SymonSaroar/sky130-riscv-soc/reports/metrics.csv

run | clock_ns | wns_ns | tns_ns | whs_ns | viol_endpoints | hold_viol | slew_viol | slew_waived | cap_viol | fmax_mhz | wns_mclk_ns | fmax_mclk_mhz | wns_pclk_ns | fmax_pclk_mhz | wns_ss_ns | fmax_ss_mhz | fmax_mclk_ss_mhz | whs_ff_ns | hold_viol_ff | die_um | util_pct | place_density | power_mw | ir_drop_mv | grt_congestion | route_drc | antenna_nets | magic_drc | klayout_drc | klayout_drc_waived | density | lvs | em_viol | lec
01-baseline | 15/10 | -10.063 | -9075.234 | 0.076 | 1210 |  | 3384 | 22 | 156 | 33.3 |  |  |  |  |  |  |  |  |  | 892x892 | 52 | 0.6000 | 8.98 |  | 0 | 0 | 65 | 1943 | 0 |  |  | mismatch
02-sram-corner | 20 |  |  |  |  |  |  |  |  |  |  |  |  |  |  |  |  |  |  |  | 52 |  |  |  | 4290
03-sram-channels | 15/10 | -8.855 | -8749.597 | 0.084 | 1218 |  | 3941 | 22 | 190 | 34.7 |  |  |  |  |  |  |  |  |  | 892x892 | 52 | 0.6000 | 9.10 |  | 0 | 0 | 48 | 0 | 0 |  |  | mismatch
04-cts-setup-repair | 20 |  |  |  |  |  |  |  |  |  |  |  |  |  |  |  |  |  |  |  | 53 |  |  |  | 0
05-placement-padding | 15/10 | -3.677 | -3405.824 | 0.077 | 1209 |  | 1834 | 22 | 145 | 42.2 |  |  |  |  |  |  |  |  |  | 892x892 | 53 | 0.6000 | 9.53 |  | 0 | 0 | 102 | 0 | 0 |  |  | clean
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
