SymonSaroar/sky130-riscv-soc/reports/48-hold-margin/pads.csv

pad | net | type | side | x_um | y_um | opening_w_um | opening_h_um | cell
1 | sdram_ba[1] | output | south | 257.500 | 84.215 | 60.000 | 70.000 | sky130_ef_io__gpiov2_pad_wrapped
2 | sdram_ba[0] | output | south | 342.500 | 84.215 | 60.000 | 70.000 | sky130_ef_io__gpiov2_pad_wrapped
3 | VSSA | analog ground | south | 417.500 | 84.600 | 60.000 | 70.000 | sky130_ef_io__vssa_hvc_clamped_pad
4 | VDDA | 3.3 V analog | south | 492.500 | 84.600 | 60.000 | 70.000 | sky130_ef_io__vdda_hvc_clamped_pad
5 | sdram_a[12] | output | south | 567.500 | 84.215 | 60.000 | 70.000 | sky130_ef_io__gpiov2_pad_wrapped
6 | sdram_a[11] | output | south | 652.500 | 84.215 | 60.000 | 70.000 | sky130_ef_io__gpiov2_pad_wrapped
7 | sdram_a[10] | output | south | 727.500 | 84.215 | 60.000 | 70.000 | sky130_ef_io__gpiov2_pad_wrapped
8 | sdram_a[9] | output | south | 812.500 | 84.215 | 60.000 | 70.000 | sky130_ef_io__gpiov2_pad_wrapped
9 | VCCD | 1.8 V core | south | 907.500 | 84.600 | 60.000 | 70.000 | sky130_ef_io__vccd_lvc_clamped_pad
10 | VSSD | core ground | south | 982.500 | 84.600 | 60.000 | 70.000 | sky130_ef_io__vssd_lvc_clamped_pad
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
