SymonSaroar/sky130-riscv-soc/reports/30-clk-100mhz/layout.png

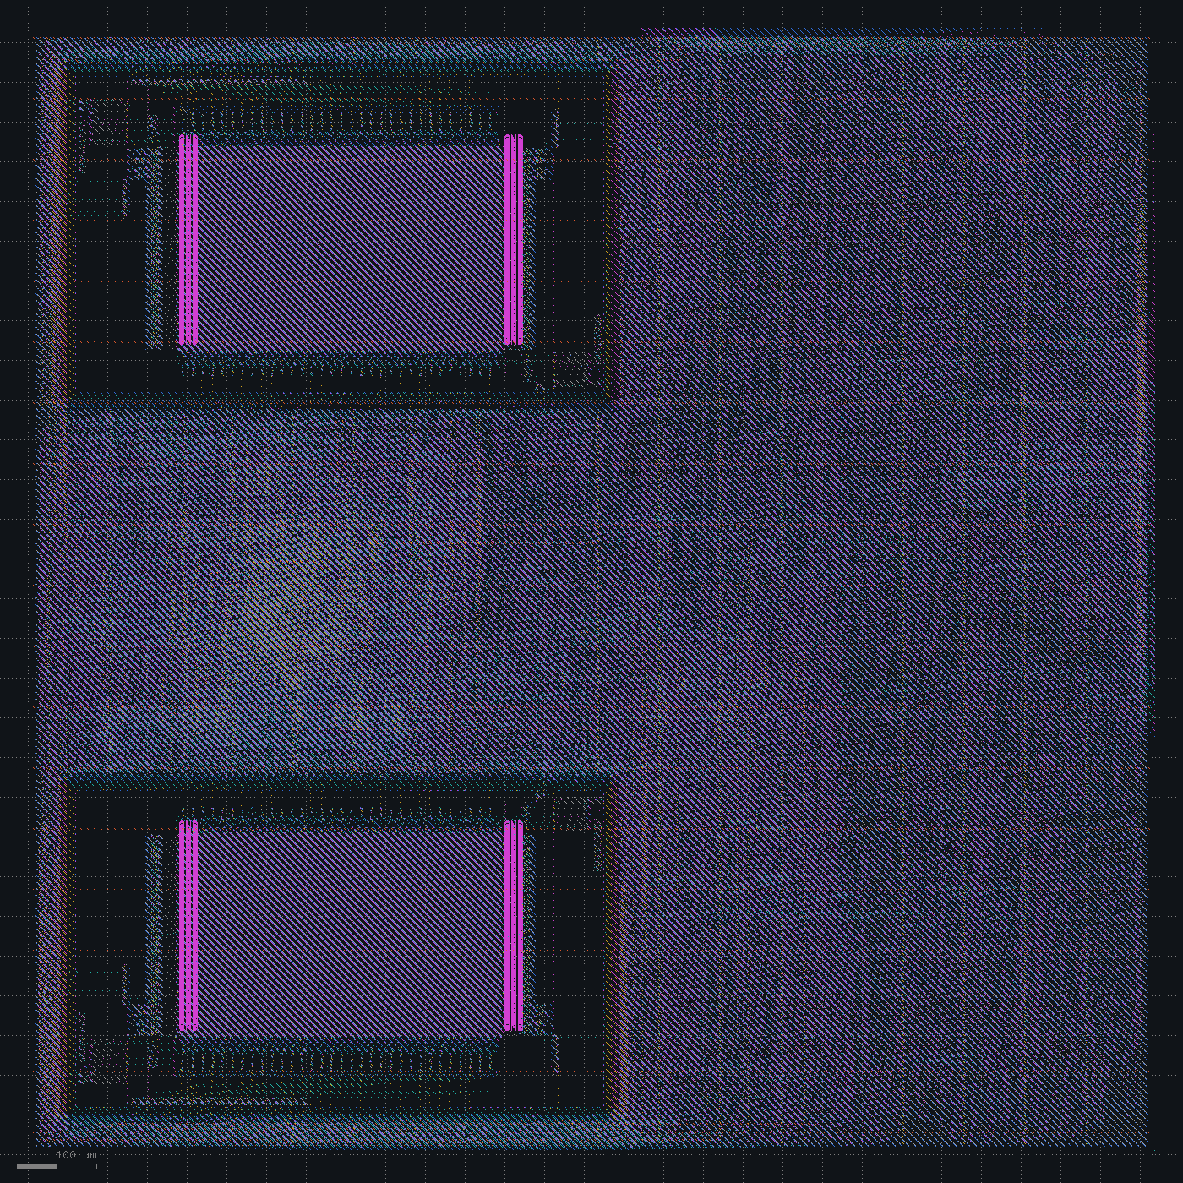
reports/30-clk-100mhz/layout.png
