SymonSaroar/sky130-riscv-soc/docs/journal/timing-optimization.md

# Timing optimization

Spec: [spec_v5.md](../spec_v5.md). The system clock target moves from 66.7 to 100 MHz (10 ns). The UART divisor becomes 868, and the delay limit on crossings between `clk` and `pclk` becomes 10 ns. RTL simulation passes. The benchmark takes 11,555 cycles cold and 10,859 warm; cold grows because a cache refill from SDRAM now costs more `clk` cycles.

| Change | Setup WNS clk / mclk / pclk (ns) | Failing endpoints | Hold WNS (ns) | DRC / LVS |
|---|---|---|---|---|
| `clk` at 10 ns | -4.11 / +2.28 / +5.30 | 1904 | +0.075 | clean |
| Register-read stage, bus request from WB registers, three-cycle multiply | -0.39 / +2.18 / +5.47 | 10 | +0.079 | clean |
| Kogge-Stone carry | -0.40 / +2.21 / +5.43 | 5 | +0.077 | clean |
| Booth-encoded multipliers | -1.02 / +2.19 / +5.41 | 34 | +0.077 | clean |
| Setup repair after CTS without buffer insertion | -1.85 / +2.19 / +5.44 | 37 | +0.077 | clean |
| Buffer insertion after CTS, multiplier operand registers, resets on constant-loaded registers | -0.54 / +1.93 / +5.39 | 11 | +0.075 | clean |
| Fetch ahead of the cache hit | +0.01 / +2.02 / +5.38 | 0 | +0.029 | clean |
| Resets on the remaining control registers | +0.24 / +1.99 / +5.36 | 0 | +0.066 | clean |

## 10 ns

Synthesis gives the same netlist as before, gate for gate: the ABC delay target follows the clock, and 10 ns maps the same as 15 ns.

`clk` misses by 4.11 ns (70.9 MHz) on 1904 endpoints. `mclk`, `pclk` and hold close, DRC and LVS are clean, and power is 63.3 mW. Every failing path starts at the EX instruction register: decode, register file read, then the ALU or an adder. They end in the register file (992), in the PCIe and SDRAM command FIFOs through the interconnect (508), at the fetch address, in the CSRs and in the multiplier's partial products.

The worst paths also carry delay chains. Timing repair after CTS builds chains of `buf_1` cells with one load each, up to 39 in a row. The longest before the PCIe port was 4; with it there were already 45, hidden by the 15 ns clock.

A candidate with a register-read stage and the bus request driven from registers ran through CTS at -3.68 ns, against -7.17 ns without it. Its worst path ran from the multiplier's partial products through their 66-bit sum, the new forwarding mux and into an operand register.

Decision: a register-read stage between ID and EX with forwarding from EX, the bus request driven from WB registers, and the multiply sum registered before writeback.

## Register-read stage

RR sits between ID and EX. It reads the register file and registers both operands, taking the EX result instead when EX writes the register being read. An instruction that reads a register still being loaded waits in RR until the cycle after the response. WB drives the bus from registers, so EX only waits for WB to be free. A multiply takes a cycle for the partial products, one for their sum and one to write back. A taken branch or jump now costs two cycles.

The benchmark takes 13,192 cycles cold and 12,484 warm, 15% more than without the stage. Five mutations each hang the firmware: no forwarding to either operand, no wait for a load in EX or in WB, and no flush of RR on a taken branch. Gate-level simulation passes.

Synthesis gives 28,610 cells (889k µm²) and 5,587 flops.

`clk` misses by 0.39 ns (96.2 MHz) on 10 endpoints, TNS -2.1 ns. `mclk`, `pclk` and hold close. DRC and LVS are clean. The die is 1426 x 1426 µm and power 66.7 mW.

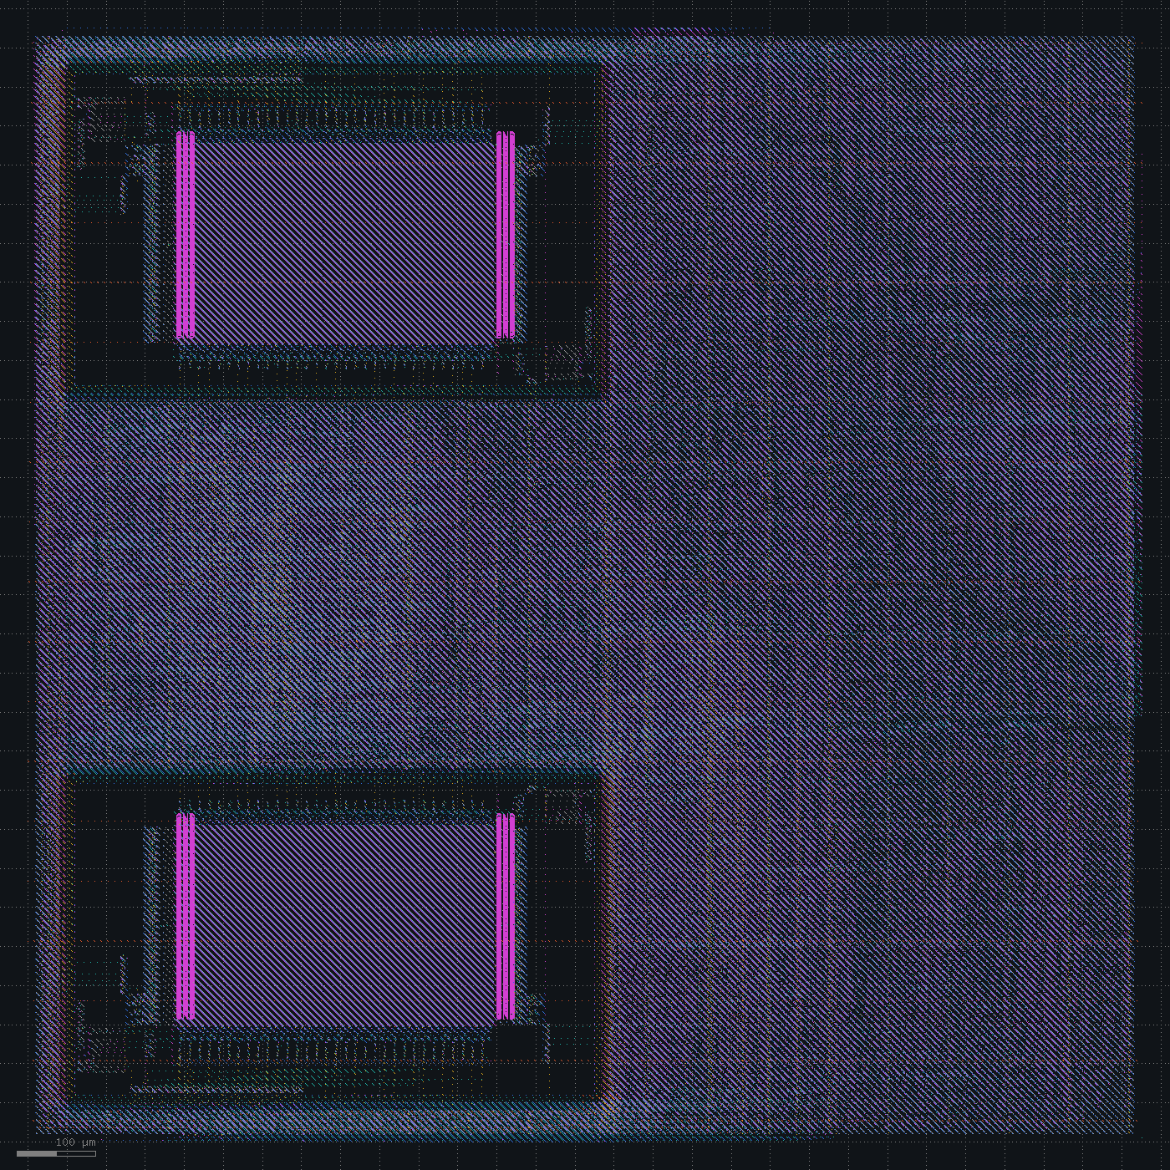
[picture p11: reports/31-register-read-stage/layout.png]
layout


The failing endpoints:

| Path | Worst slack (ns) | Endpoints |
|---|---|---|
| EX instruction register to the fetch address, through the branch target adder | -0.39 | 5 |
| Partial products to the multiply sum | -0.38 | 2 |
| Operand to the partial products | -0.21 | 3 |

The worst path is 46 cells. After decode and the immediate select, the target adder `pc + imm` is a chain of about 30 cells, 7.6 ns. Yosys builds the carry as a Brent-Kung tree, and ABC maps it into that chain. Delay chains are shorter here: the longest is 21, and the failing paths carry at most 10.

Decision: Kogge-Stone carry for adders and comparators in synthesis.

## Kogge-Stone carry

Synthesis maps the carry of every adder and comparator as a Kogge-Stone tree. The design grows by 2k µm² to 891k µm² and 28,797 cells. Gate-level simulation passes.

The fetch address and the multiply sum now close. `clk` still misses by 0.40 ns (96.2 MHz), on 5 endpoints, TNS -0.82 ns, all of them partial-product registers. From the operand register, the 17x17 multiply takes about 10 ns, 48 cells including 6 rebuffers. `mclk`, `pclk` and hold close. DRC and LVS are clean. Power rises from 66.7 to 88.3 mW; the vectorless estimate puts the increase in combinational logic, 4.1 to 25.9 mW. `u_sram.mem/dout1[10]` is over its load limit again, 0.07 against 0.03 pF.

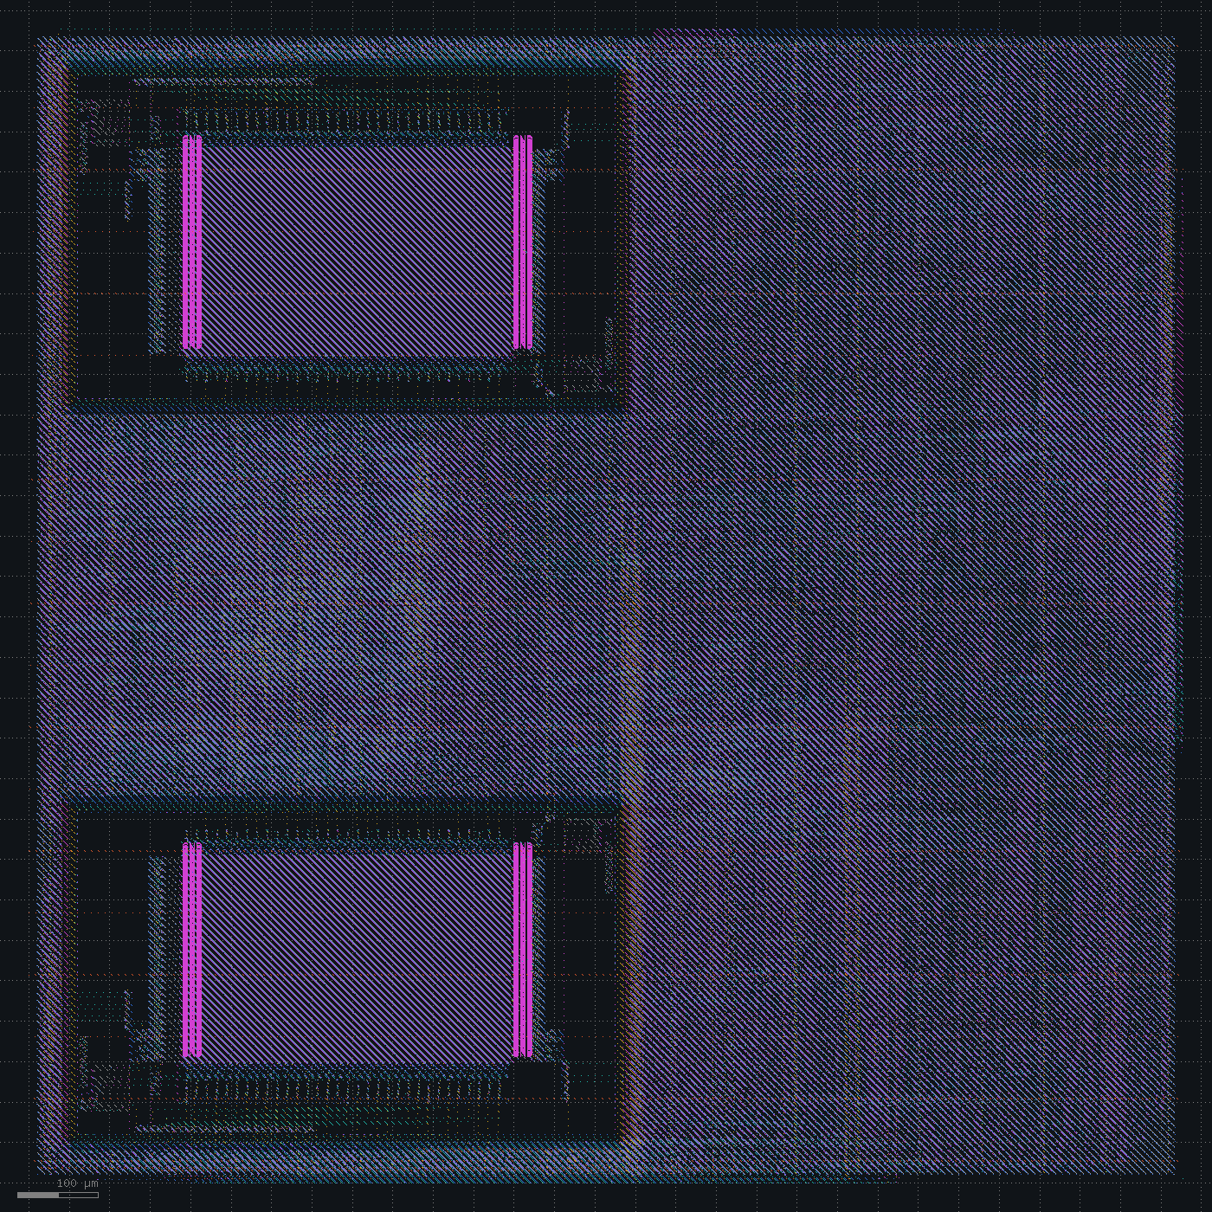
[picture p12: reports/32-kogge-stone/layout.png]
layout


A candidate with Booth-encoded multipliers ran through CTS. No partial-product register was among its 400 worst endpoints; 21 were with Kogge-Stone carry alone.

Decision: Booth-encoded multipliers.

## Booth multipliers

Synthesis builds the multipliers with Booth encoding: 27,766 cells and 882k µm², 9k µm² less than before.

`clk` gets worse: -1.02 ns (90.7 MHz) on 34 endpoints. `mclk`, `pclk` and hold close, DRC and LVS are clean, and one antenna net is left. Power drops to 66.8 mW.

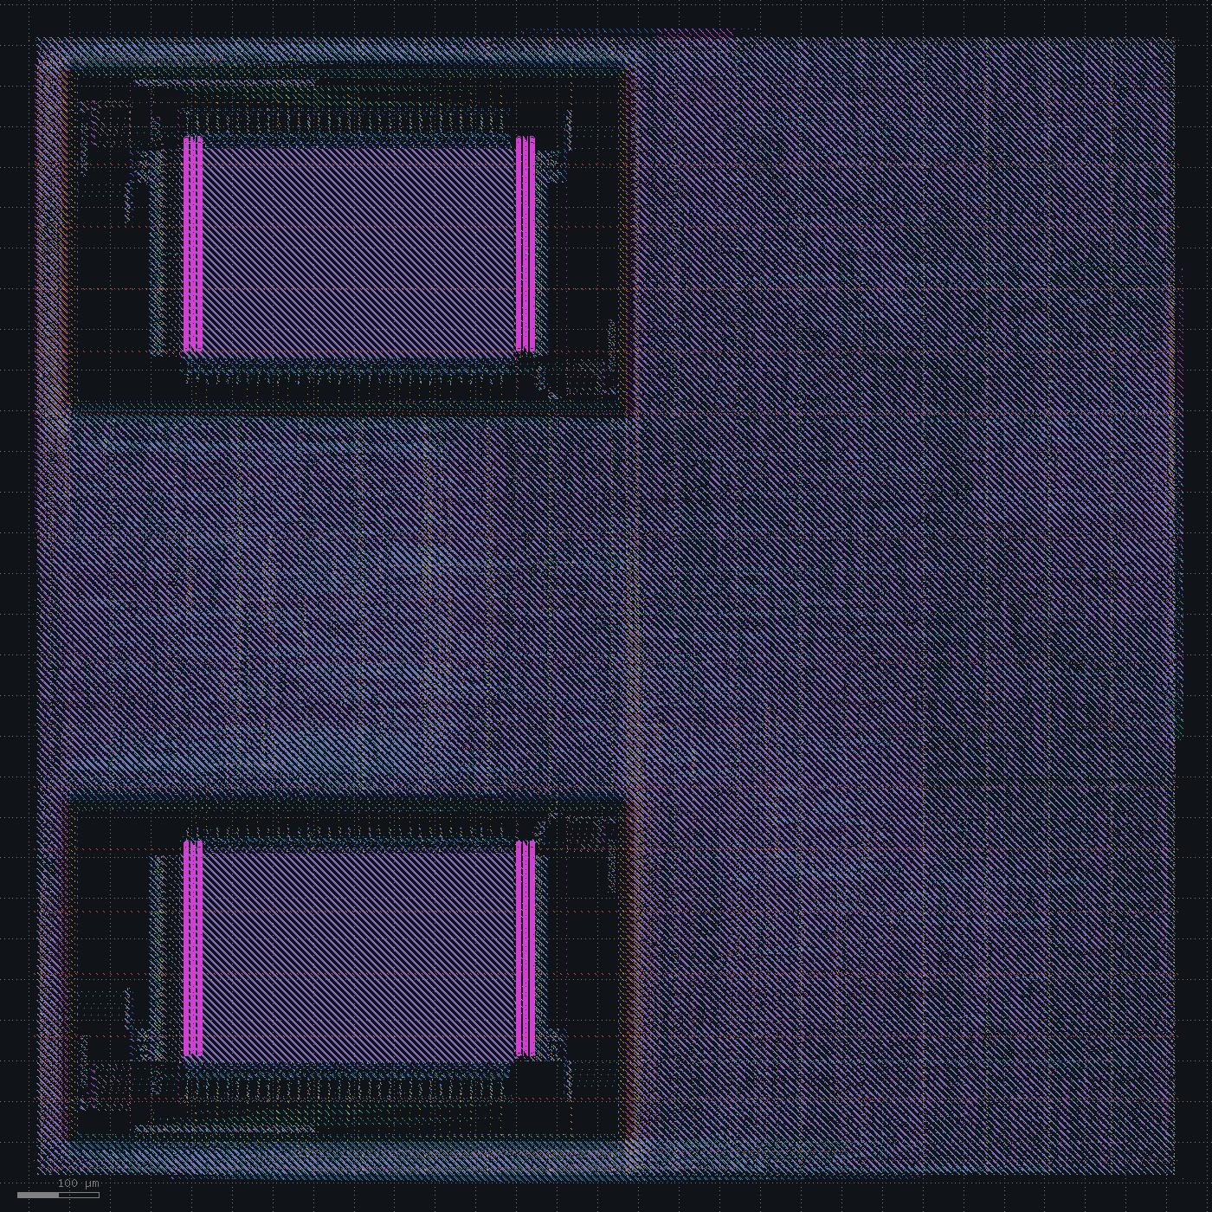
[picture p13: reports/33-booth/layout.png]
layout


| Path | Worst slack (ns) | Rebuffers on the worst path |
|---|---|---|
| Operand to a partial-product register | -1.02 | 47, 5.9 ns |
| Instruction cache hit to the fetch address | -0.94 | 4, 0.65 ns |
| SRAM load data to the register file | -0.11 | 0 |

The multiplier logic on the worst path takes 5.7 ns, then 37 rebuffers in a row, all within 15 µm of each other, add 4.3 ns. The Kogge-Stone layout's failing paths carried 1.1 to 1.2 ns of rebuffers as well. Setup repair after CTS works from the placement estimate, which starts at -11.74 ns here; signoff ends at -1.02 ns. The repair after global routing has skipped buffer insertion for the same kind of gap since it went resize-only.

Gate-level simulation hangs at the first PCIe read. The receive CRC `rp_crc` has no reset and is loaded with all ones when the check of a TLP starts. In this netlist the load leaves it X, and the X reaches the transaction FSM through the LCRC compare. The Kogge-Stone netlist, from the same RTL, passes.

Decision: setup repair after CTS without buffer insertion.

## No buffer insertion after CTS

Setup repair after CTS only resizes, swaps pins and clones: 1197 cells resized, 183 cloned, no buffers. The netlist is the same as with Booth multipliers.

`clk` gets worse again: -1.85 ns (84.4 MHz) on 37 endpoints. `mclk`, `pclk` and hold close, DRC and LVS are clean, and power is 66.8 mW. No failing path carries a rebuffer, but the same paths are slower without them:

| Path | With buffering, worst slack (ns) | Without, worst slack (ns) |
|---|---|---|
| Operand to a partial-product register | -1.02 | -1.85 |
| Instruction cache hit to the fetch address | -0.94 | -1.55 |

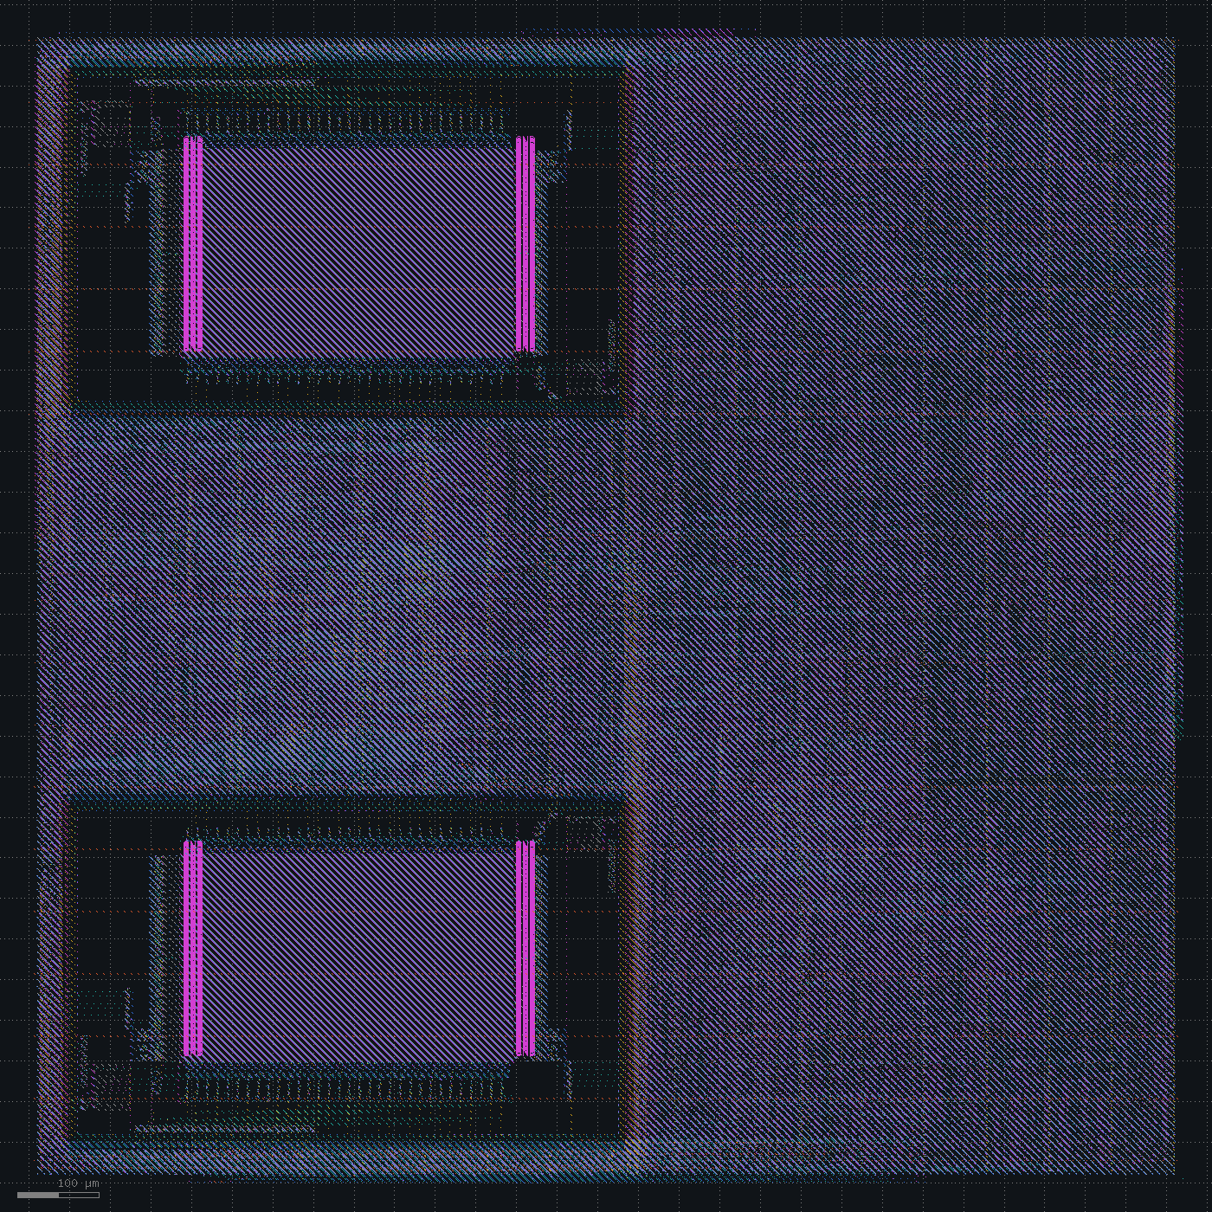
[picture p14: reports/34-cts-no-buffering/layout.png]
layout


Buffer insertion after CTS does real work, chains included.

The multiplier operands are `x1` and `x2`, which also feed the ALU, the shifter, the comparators, the address adder and the divider. On the Kogge-Stone layout's worst path the operand bit passed four buffers, 1.2 ns, before the first multiplier gate. The receive CRC is not the only register that is loaded with a constant before first use and has no reset: so are the transmit CRC, the K flags of the retry buffer, the divider's remainder and count, and the cache refill counter.

Decision: buffer insertion after CTS again, multiplier operands in their own registers, loaded in RR for a multiply only, and a reset on every register that is loaded with a constant before first use.

## Multiplier operand registers

RR loads two 33-bit multiplier operand registers, sign-extended, only when the instruction is a multiply. The partial products start from them. Six more registers get a reset. Synthesis gives 28,023 cells and 5,658 flops. Two mutations fail check 38: operands without forwarding, and without sign extension. Gate-level simulation passes, the PCIe test included.

The multiplier closes: its worst path has +0.42 ns. `clk` misses by 0.54 ns (94.8 MHz) on 11 endpoints, all of them on one path: the cache tag lookup and hit compare, then the select of the next fetch address, into `f_pc`, the cache's address register and the fetch source flag. The path is 53 cells with 0.7 ns of rebuffers. `mclk`, `pclk` and hold close. DRC and LVS are clean. Power is 67.9 mW.

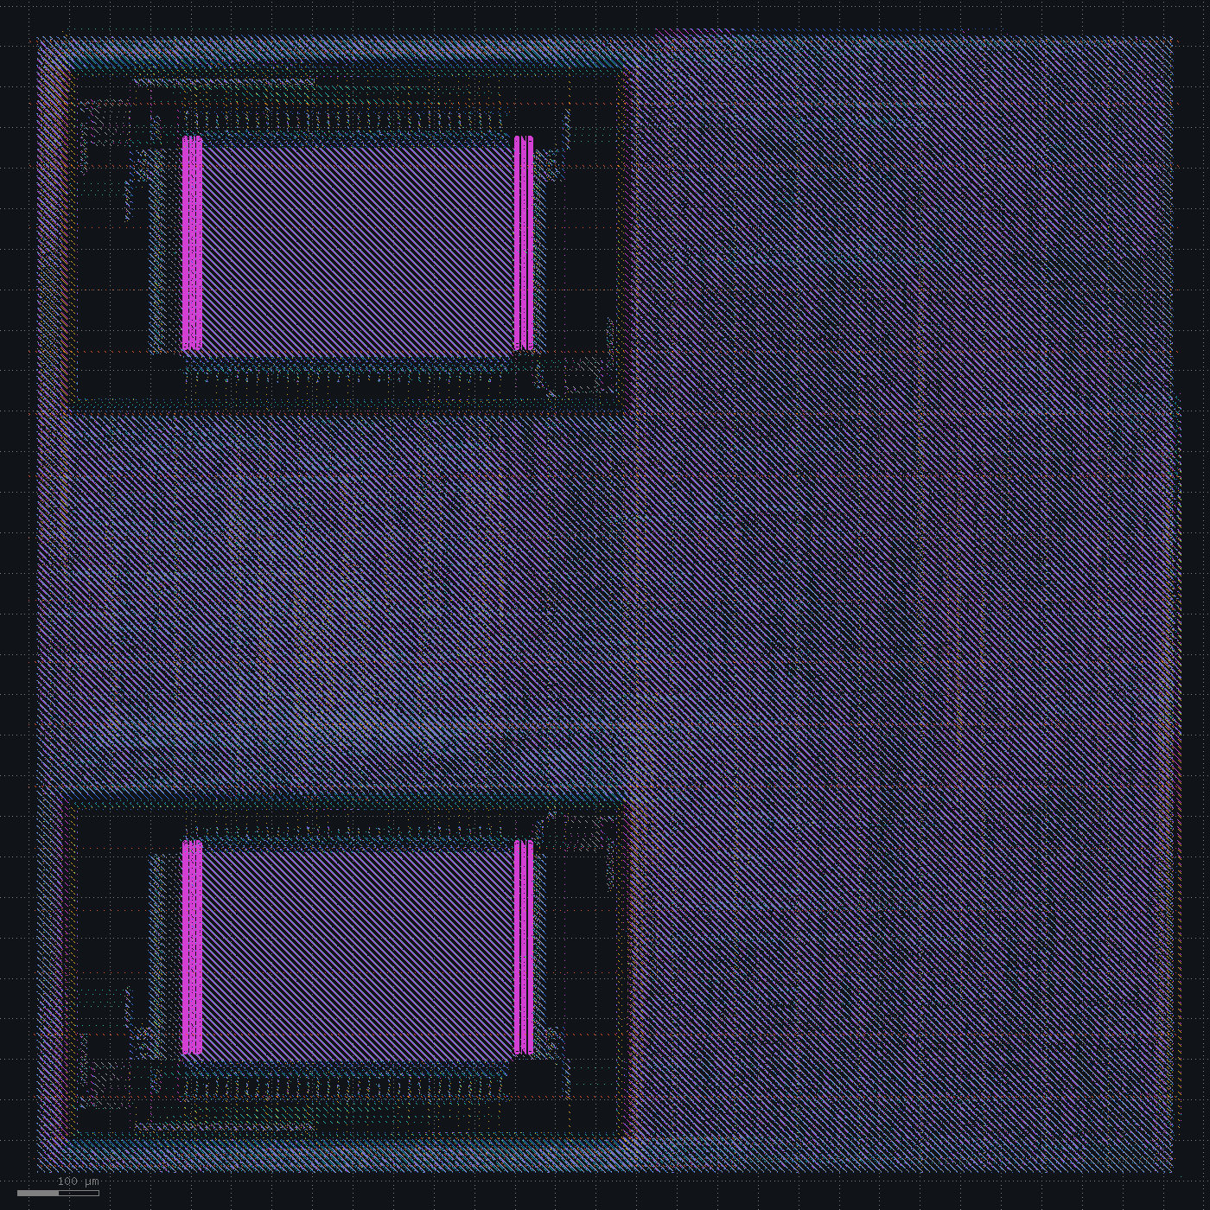
[picture p15: reports/35-mul-operand-regs/layout.png]
layout


Decision: fetch runs ahead without waiting for the cache hit; after a miss, the next fetch goes back to the address that missed.

## Fetch ahead of the cache hit

The next fetch address no longer depends on the cache hit. After a miss, a registered flag sends the next fetch back to the address that missed and drops the word already in flight, so a miss costs at most one more cycle. The benchmark cycle counts do not change. Two mutations fail: keeping the word in flight fails check 42, and not going back hangs the firmware.

Timing closes at 10 ns: `clk` +0.01 ns (100.1 MHz), `mclk` +2.02 ns, `pclk` +5.38 ns, hold +0.029 ns. DRC and LVS are clean. Power is 67.3 mW.

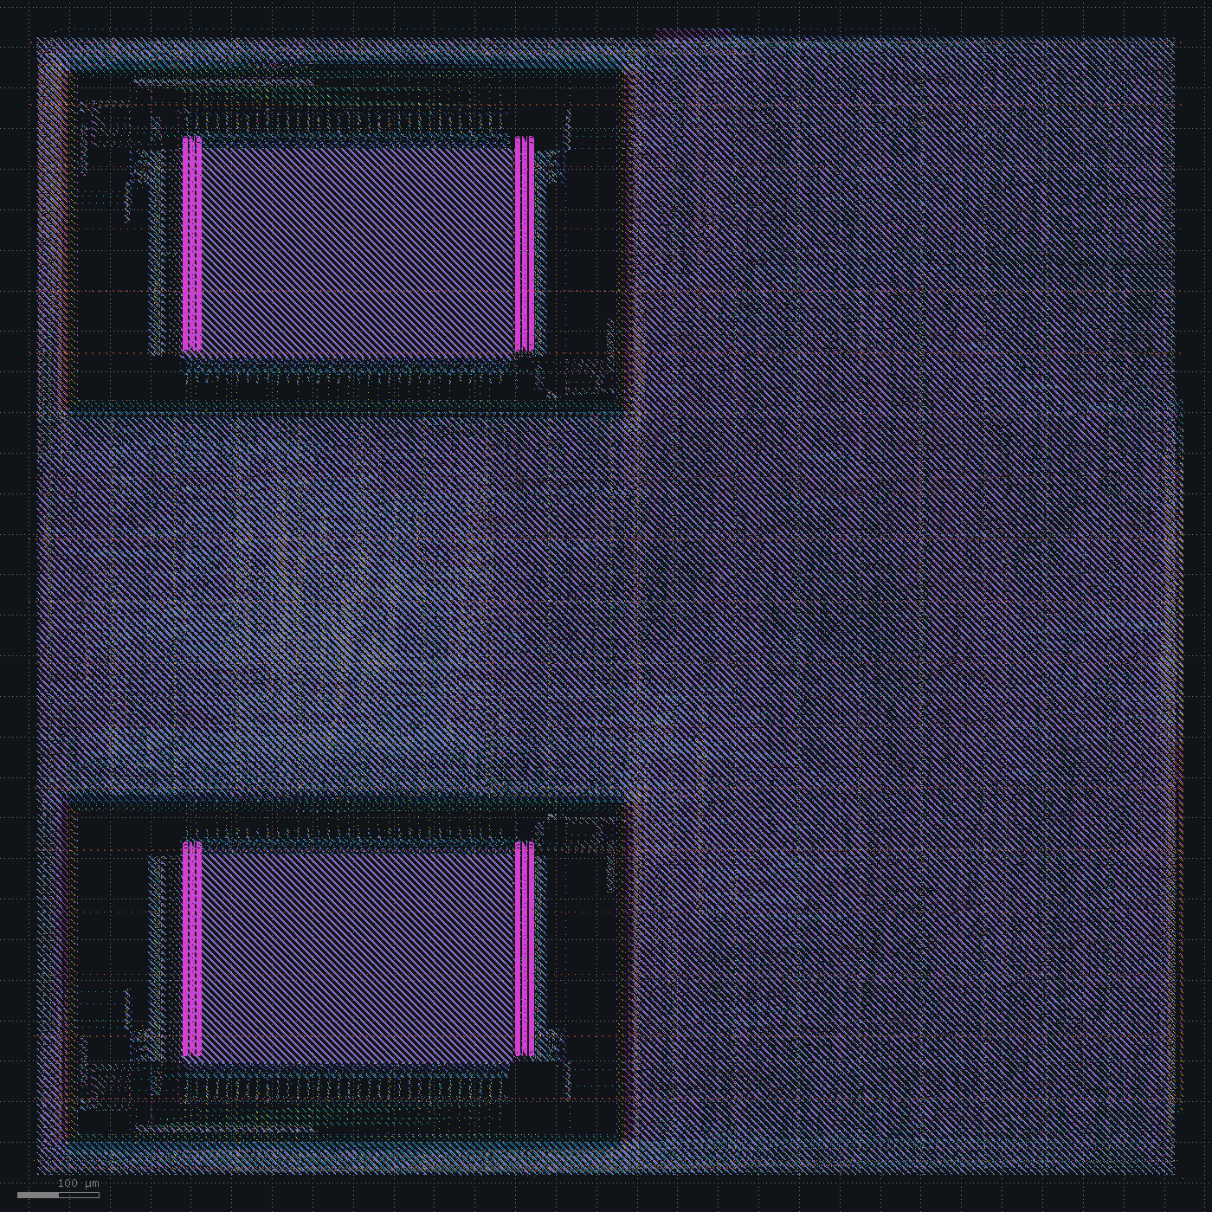
[picture p16: reports/36-fetch-ahead/layout.png]
layout


The worst paths now load from SRAM: the macro's read data arrives 7.8 ns into the cycle, and the interconnect read mux, the byte select and the register file write take the remaining 3.9 ns.

Gate-level simulation prints nothing. The first status read of the UART returns X in the busy bit, which turns the polling branch and then the fetch address into X. The UART's bit counter `tbits` has a reset, but it counts down when `tcnt` reaches 0, and the baud counter `tcnt` has none; in this netlist that X reaches `tbits` while the UART is idle. The other control registers without a reset: the receive baud counter, the interconnect's response selects, the write flags of the SDRAM and PCIe ports, and the CPU's load flag.

Decision: a reset on each of them.

## Control resets

The UART baud counters, the interconnect's response selects, the write flags of the SDRAM and PCIe ports and the CPU's load flag now have a reset. Synthesis gives 27,890 cells and 5,691 flops.

Timing closes with more room: `clk` +0.24 ns (102.4 MHz), `mclk` +1.99 ns, `pclk` +5.36 ns, hold +0.066 ns. The closest paths are the multiplier's partial products (+0.24 ns) and loads from SRAM (+0.35 ns). DRC and LVS are clean, antennas are at 0, and power is 67.9 mW. One net, `_06097_`, a `nor2_2` with 12 loads, is 4% over its slew limit and 7% over its load limit.

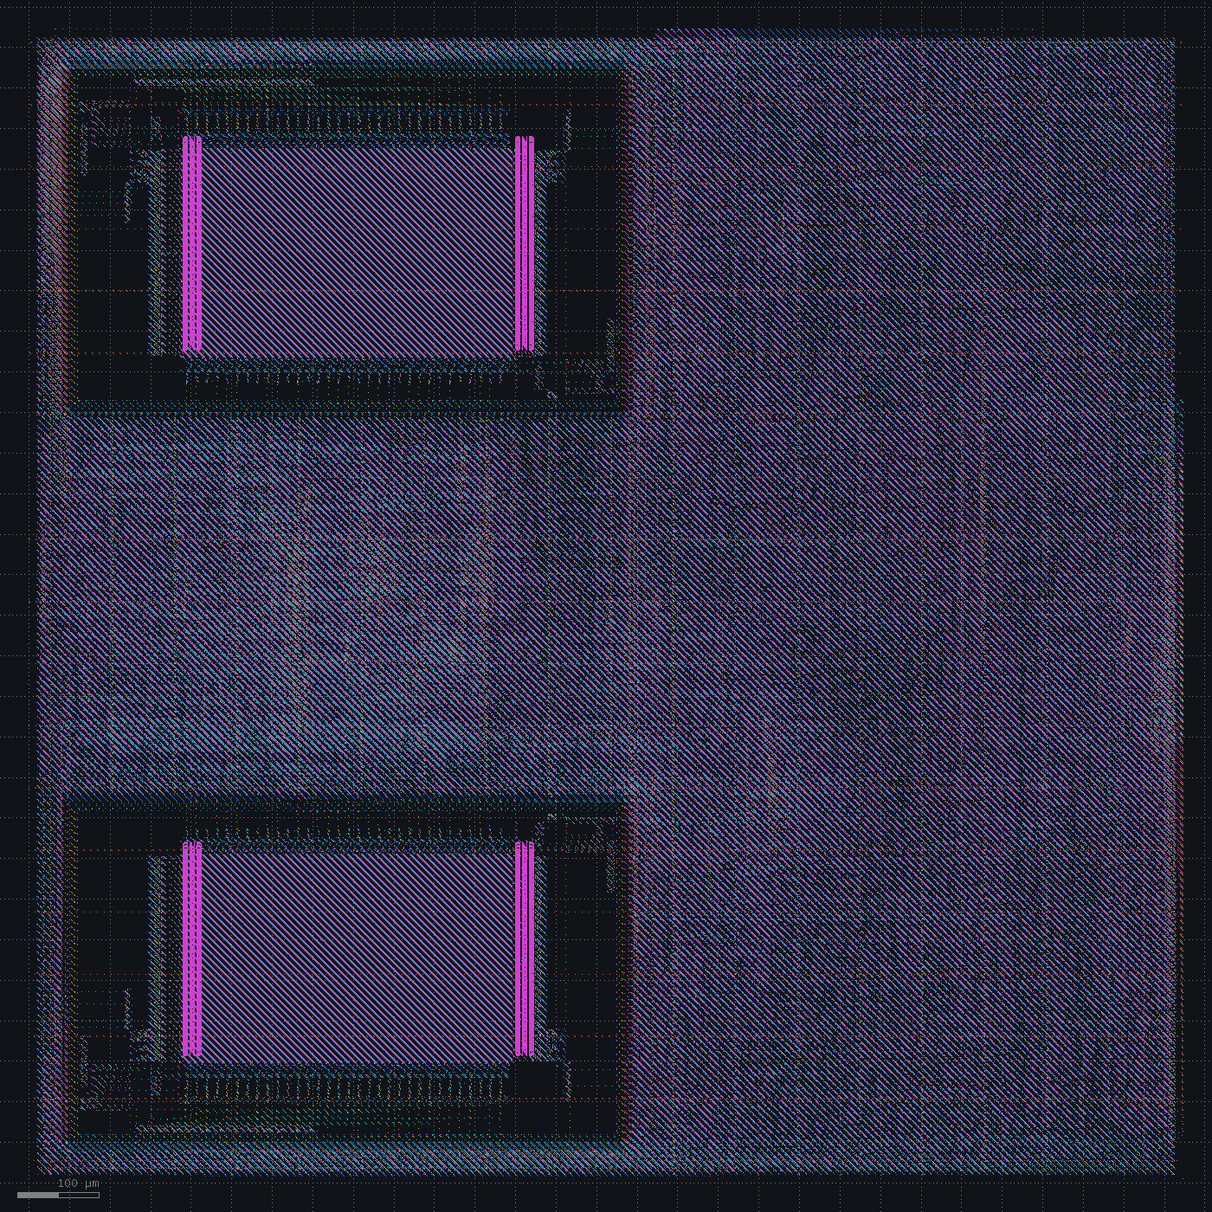
[picture p17: reports/37-control-resets/layout.png]
layout


Gate-level simulation still hangs, this time one cycle after reset: the interconnect's busy flag turns X. Nothing requests the bus, but the slave decode reads the cache's refill address, which has no reset, and this netlist lets the X through. Every netlist since the PCIe port has hung on some register that the RTL masks and that would power up as 0 or 1 in silicon; each mapping exposes a different one.

Decision: gate-level simulation starts every flop at 0, and again at 1, instead of X. The simulation copy of the cell library's flop primitives gets an initial value; the PDK files are unchanged.

On this netlist both simulations pass, with the same cycle counts as RTL.

## Status

The system clock closes at 100 MHz in the typical corner with 0.24 ns to spare. RTL simulation passes, and gate-level simulation passes with flops starting at 0 and at 1.

| | Before | After |
|---|---|---|
| CPU stages | IF, ID, EX, WB | IF, ID, RR, EX, WB |
| `clk` | 66.7 MHz target, 71.1 MHz max | 100 MHz target, 102.4 MHz max |
| Benchmark, warm | 10,859 cycles, 163 µs | 12,484 cycles, 125 µs |
| Die (µm) | 1419 x 1419 | 1423 x 1423 |
| Standard-cell area (µm²) | about 312k | about 317k |
| Power (mW) | 47.5 | 67.9 |

Open:

- `u_sram.mem/dout1[10]` drives 0.07 pF against 0.03 pF, back since Kogge-Stone carry.
- `_06097_` is 4% over its slew limit and 7% over its load limit.
