SymonSaroar/sky130-riscv-soc/docs/journal/place-and-route-cleanup.md

# Place and route cleanup

Starting point: the external memory design. Timing and hold close, DRC and LVS are clean, 74 nets have antenna violations, and the die is 923 x 923 µm with standard cells filling about a fifth of it.

| Change | Die (µm) | Antenna nets | Setup WNS clk / mclk (ns) | Hold WNS (ns) | DRC / LVS |
|---|---|---|---|---|---|
| Antenna repair after detailed routing | 923 x 923 | 0 | +4.51 / +2.14 | +0.074 | clean |
| Core utilization 50% to 60% | 844 x 844 | 2 | +4.69 / +1.97 | +0.069 | clean |
| Up to 12 antenna passes | 844 x 844 | 0 | +4.69 / +1.97 | +0.069 | clean |
| Power pins and IR drop | 844 x 844 | 1 | +4.80 / +1.96 | +0.070 | clean |
| Buffer in front of gates the diodes cannot fix | 844 x 844 | 0 | +4.78 / +1.96 | +0.070 | clean |

## Antenna repair after detailed routing

The 74 violations are all side-area ratio checks: met2 41, met1 29, met3 19, met4 2. The median net is 1.27 times over the limit and the worst 8.4 times. The flow repairs antennas on the global routes, and detailed routing then lays different wires.

After detailed routing, the flow now checks antennas, inserts diodes on the violating nets, and reroutes only the changed nets, up to six times. Here it takes three passes: 74 nets, then 10, then 2, then 0. The passes add 112 diodes, on top of the 44 inserted after global routing.

Timing does not change: `clk` +4.51 ns, `mclk` +2.14 ns, hold +0.074 ns. DRC and LVS are clean.

## Smaller die

First, a sweep in a scratch copy of the flow ran floorplan, placement, CTS and global routing at three targets:

| Core utilization | Die (µm) | Result |
|---|---|---|
| 60% | 844 x 844 | Global routing clean |
| 65% | 812 x 812 | 1393 vertical congestion spots, all over the SRAM |
| 70% | 783 x 783 | Detailed placement fails during CTS |

At 65%, the area above the SRAM is too small and logic spills into the channels around it. Every net from those cells to the logic above crosses the macro, where the vertical routing capacity is close to zero. Three variants at 65% did not route:

| Variant at 65% | Result |
|---|---|
| SRAM flipped (MX), port 0 facing the logic | 1556 congestion spots |
| Channels blocked for placement, 2 rows kept for the SRAM input buffers | Detailed placement fails: 26 cells, mostly SRAM buffers |
| Aspect ratio 0.8 (906 x 729 µm) | 137 congestion spots |
| Aspect ratio 0.7 (967 x 683 µm) | 1098 congestion spots |

Decision: 60%.

The die shrinks from 923 x 923 to 844 x 844 µm, 16% less area. Utilization is 64%. Global routing has no congestion. Setup still closes: `clk` 65.3 MHz, `mclk` 124.5 MHz. Hold is +0.069 ns. Power is 16.7 mW. DRC and LVS are clean.

The antenna loop stops at its limit of six passes with 2 nets left (86, 13, 7, 4, 4, 3, 2). Both are met1 side-area checks, at 488 and 455 against 400. On that database, five more diode passes reach 0. A 10% `-ratio_margin` oscillates between 1 and 2 nets, and `-jumper_only` leaves both.

Decision: allow up to 12 passes.

## Longer antenna loop

The loop reaches 0 on its eleventh pass: 86, 13, 7, 4, 4, 3, 2, 2, 2, 2, 2, 0. Timing, power, DRC and LVS match the 60% layout.

The macro has no power pins. VPWR and VGND exist only as internal met4 and met5 stripes, so nothing outside the block can connect to them, and the IR drop has never been measured.

Decision: promote the met5 stripes to VPWR and VGND pins that reach the die edge, and add a static IR drop step fed from those pins.

## Power pins and IR drop

The met5 stripes extend to the die edge as pins: 16 shapes on VPWR and 18 on VGND. LVS stays clean with the new ports. `power/ir.tcl` runs static IR analysis on both supplies with sources at those pins.

| Supply | Worst IR drop | Average |
|---|---|---|
| VPWR | 1.60 mV (0.09%) | 0.45 mV |
| VGND | 1.53 mV (0.08%) | 0.31 mV |

Timing, DRC and LVS are unchanged.

One antenna net is left after twelve passes (80, 7, 3, 3, 2, 2, then 1 for seven passes). Net `_07795_` drives seven gates across 180 µm. It has collected 12 diodes, and its met1 segment into `_12206_/A0` is still at 850 against 400. The checker's required ratio does not move, so the diodes are not on the met1 segment that reaches that gate. On that database, a buffer in front of `_12206_/A0` clears it in one pass.

Decision: four diode passes, then a buffer in front of every gate that still violates.

## Antenna buffers

Inside the routing process, the buffer insertion failed twice. First `insert_buffer` stopped with EST-0104 (inconsistent parasitics state). After a reset to placement parasitics, detailed routing stopped with DRT-0218 on nets of cells that legalization had moved. The same steps work in a new OpenROAD process started from the saved database. Routing is now two processes: `route.tcl` ends after the diode passes and writes `droute.odb`, and `finish.tcl` loads it, buffers the remaining gates, places fillers and writes the outputs.

With the finish step the diode passes go 80, 7, 3, 3, and 2 nets are left. Two buffers clear them. The netlist has 197 antenna diodes and 2 antenna buffers.

| Check | Result |
|---|---|
| Antenna nets | 0 |
| Setup | `clk` +4.78 ns (65.7 MHz), `mclk` +1.96 ns (124.4 MHz) |
| Hold | +0.070 ns |
| IR drop | 1.60 mV |
| Global route congestion | 0 |
| DRC / LVS | clean |

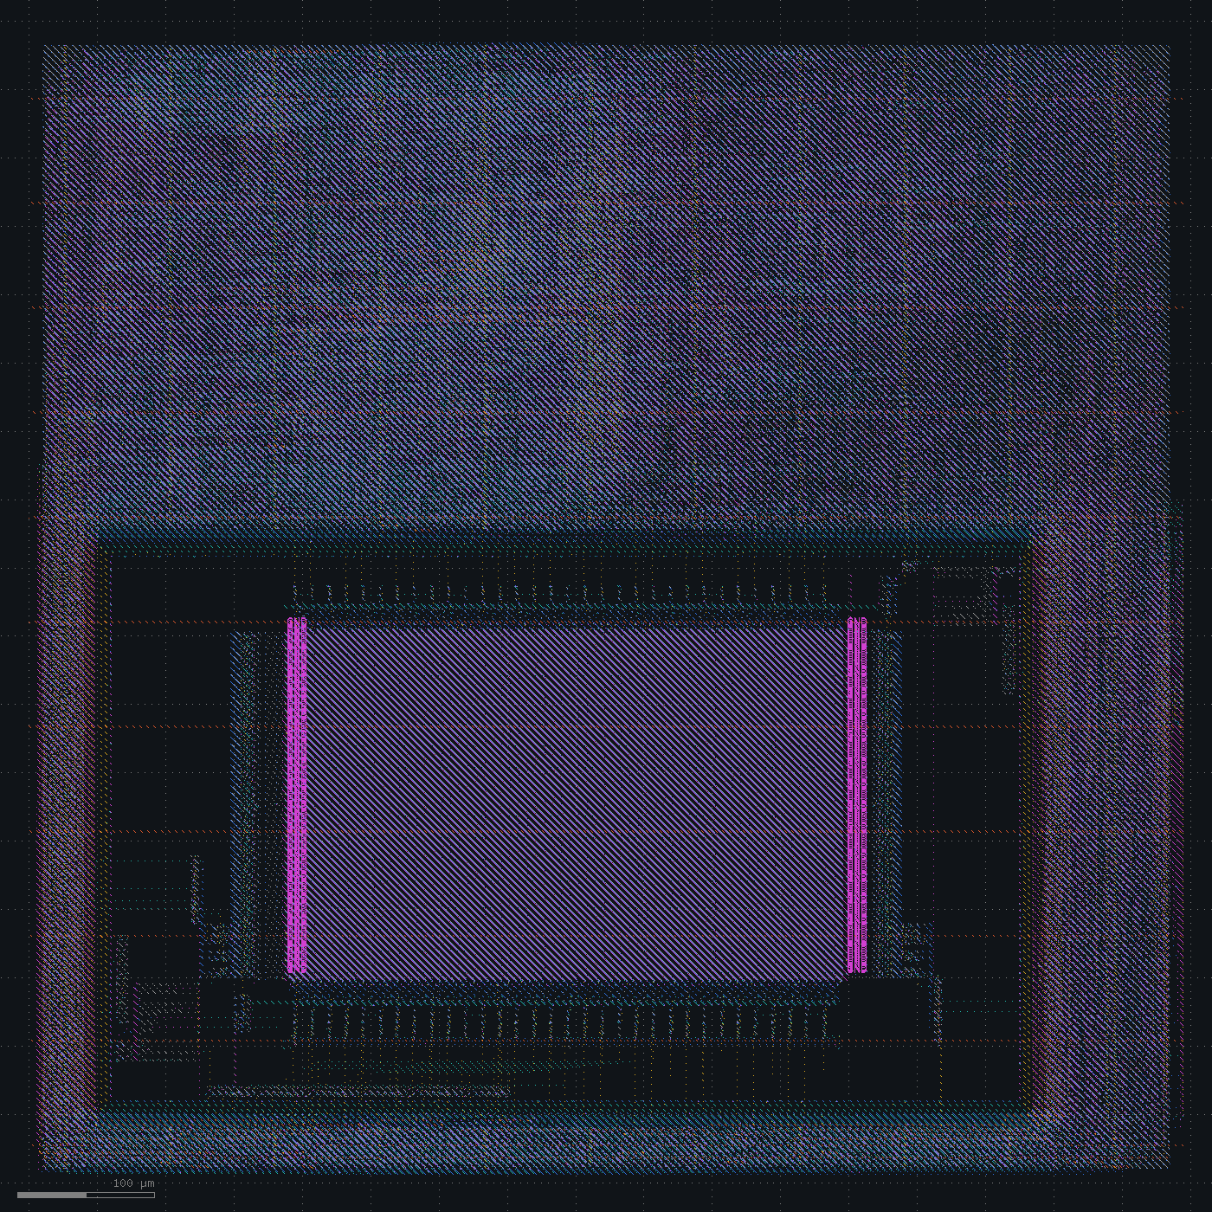
[picture p22: reports/19-antenna-buffers/layout.png]
layout


## Status

The die is 844 x 844 µm, 16% smaller than before. There are no antenna violations, the macro has VPWR and VGND pins, and static IR drop is 1.6 mV. Timing, DRC and LVS stay clean.
