SymonSaroar/sky130-riscv-soc/(commit log)

2026-07-09 write the SoC spec
    RV32I core booting from SPI flash, AXI4-Lite interconnect, 2 KB SRAM and APB
    peripherals, on SKY130 with open tools.
2026-07-09 add RV32I core
    Zicsr with machine-mode interrupts. Fetch reads the SRAM read port; data goes
    over AXI4-Lite.
2026-07-09 add UART
2026-07-09 add GPIO, timer and interrupt controller
2026-07-09 add SPI master and flash boot loader
    The boot loader copies 2 KB from flash into SRAM, then releases the core.
2026-07-09 add self-test firmware
    ISA checks, timer and UART interrupts, SPI read.
2026-07-10 add floorplan and power grid
2026-07-14 keep an LVS summary and count antenna nets
2026-07-14 update journal with the baseline implementation
    Macro placed by rtl_macro_placer, 50% core utilization, no setup repair.
    WNS -10.06 ns at 50 MHz. Magic DRC 1943, LVS mismatch, KLayout DRC clean,
    65 antenna nets.
    [metrics.csv]
2026-07-16 update journal with the SRAM in the core corner
    Global routing fails with 4290 congestion violations over the macro.
    [metrics.csv]
2026-07-16 update journal with the SRAM routing channels
    Routing completes with 0 DRC. WNS -8.86 ns. LVS mismatch on the decap_3
    filler power pins.
    [metrics.csv]
2026-07-16 fix LVS mismatch on the filler power pins
2026-07-19 update journal with setup repair after CTS
    Post-CTS estimate -0.06 ns. Detailed routing did not finish in 3 hours.
    [metrics.csv]
2026-07-20 update journal with placement padding
    Detailed routing converges in 13 passes. DRC and LVS clean. WNS -3.68 ns,
    1209 failing endpoints, 42.2 MHz.
    [metrics.csv]
2026-07-22 update journal with the instruction register
    Paths through the fetch port +9.1 ns. WNS -4.74 ns, 1275 failing endpoints,
    all from SRAM dout0. DRC and LVS clean.
    [metrics.csv]
2026-07-22 stall on load use instead of forwarding the load
    [rv32i.v]
2026-07-24 update journal with the load-use stall
    WNS -0.23 ns, 19 failing endpoints, 49.4 MHz. DRC and LVS clean. Extracted
    wire capacitance is 2.40x the placement estimate.
    [metrics.csv]
2026-07-24 calibrate estimated wire RC to OpenRCX
    8.93e-4 kohm/um and 1.87e-4 pF/um.
2026-07-24 update journal with the calibrated wire capacitance
    Setup closes: WNS +2.78 ns, 58.1 MHz. 229 slew and 37 load violations.
    [metrics.csv]
2026-07-24 buffer every SRAM input next to its pin
2026-07-26 update journal with the SRAM input buffers
    SRAM input slews drop to about 0.1 ns. WNS +4.24 ns, 63.4 MHz.
    [metrics.csv]
2026-07-26 estimate global-route RC from the LEF layers
    Capacitance scaled 2.40x at placement and 1.91x after global routing.
2026-07-26 update journal with repair after global routing
    WNS +5.69 ns, 69.9 MHz, hold +0.079 ns, 0 load violations, 22 slew
    violations on the SRAM pins. DRC and LVS clean.
    [metrics.csv]
2026-07-26 show antenna nets in the README table
    [metrics.csv]
2026-07-29 update journal with the SDRAM port
    Setup closes in both domains (68.4 / 151 MHz); hold fails on 32 SDRAM
    outputs (-0.256 ns). DRC and LVS clean.
    [metrics.csv]
2026-07-29 update journal with hold repair
    Signoff still has 32 failing SDRAM outputs (-0.222 ns).
    [metrics.csv]
2026-08-02 update journal with the falling-edge SDRAM pins
    No hold failures. clk 64.5 MHz, mclk 127 MHz. DRC and LVS clean.
    [metrics.csv]
2026-08-02 update journal with the bounded clock crossings
    clk->mclk +8.42 ns, mclk->clk +5.45 ns.
    [metrics.csv]
2026-08-02 repair antennas on the detailed routes
    Up to six diode passes.
2026-08-02 update journal with antenna repair
    74 violating nets go to 0 in three passes.
    [metrics.csv]
2026-08-02 update journal with 60% core utilization
    Die 844x844 um. Setup and hold close, DRC and LVS clean, 2 antenna nets left.
    [metrics.csv]
2026-08-02 allow 12 antenna repair passes
2026-08-02 update journal with 12 antenna repair passes
    0 violating nets after 11 passes.
    [metrics.csv]
2026-08-03 add met5 power pins
2026-08-04 update journal with power pins and IR drop
    Worst IR drop 1.60 mV. LVS clean. One antenna net left.
    [metrics.csv]
2026-08-07 move antenna repair to a finish step with a buffer fallback
    Four diode passes, then a buffer in front of every gate still violating.
2026-08-07 update journal with the antenna finish step
    0 antenna nets; timing, IR, DRC and LVS clean.
    [metrics.csv]
2026-08-10 boot in two stages
    A loader in SRAM copies the program from flash into SDRAM.
2026-08-10 update journal with RV32M, the instruction cache and the 15 ns clock
    Die 1178x1178 um. clk -3.08 ns (928 failing), mclk +1.81 ns, hold clean,
    DRC and LVS clean.
    [metrics.csv]
2026-08-10 fix divider latching an operand still being loaded
    M operations wait for pending loads on their operands.
    [rv32i.v]
2026-08-10 update journal with the two-cycle multiplier
    Post-CTS estimate -0.89 ns. Detailed routing stopped at 38,134 violations.
    [metrics.csv]
2026-08-10 update journal with resize-only timing repair
    Detailed routing stalls near 17,400 violations.
    [metrics.csv]
2026-08-16 update journal with 52% core utilization
    Placement keeps density 0.60; detailed routing stalls near 10,700
    violations beside the register file.
    [metrics.csv]
2026-08-16 update journal with 45% core utilization
    Die 1361x1361 um. clk 78.8 MHz, mclk 126 MHz, hold, DRC, LVS and antennas
    clean. One load violation on SRAM dout1[10].
    [metrics.csv]
2026-08-16 buffer every SRAM output at its pin
2026-08-16 update journal with the SRAM output buffers
    clk 77.6 MHz, mclk 126 MHz, hold, DRC, LVS and antennas clean.
    [metrics.csv]
2026-08-19 update journal with the PCIe root port
    Die 1413x1413 um, 424 pins. clk +1.43 ns, mclk +2.39 ns, pclk +4.54 ns,
    hold, DRC and LVS clean. Gate-level simulation hangs on an unreset replay
    timer.
    [metrics.csv]
2026-08-23 fix gate-level hang: reset the replay timer
2026-08-23 update journal with the falling-edge PIPE inputs
    No hold buffers. clk +0.88 ns, mclk +2.28 ns, pclk +5.55 ns. Gate-level
    simulation hangs on an unreset receive byte counter.
    [metrics.csv]
2026-08-23 buffer every input pin
2026-08-23 update journal with the link-layer resets
    Gate-level simulation passes. clk +0.93 ns, mclk +2.26 ns, pclk +5.31 ns.
    Three antenna nets left by the finish step.
    [metrics.csv]
2026-08-23 fix antennas from the finish reroute
    Diode passes repeat after the antenna buffers and reroute.
2026-08-23 update journal with the finish-step diode passes
    Antennas 0, DRC and LVS clean.
    [metrics.csv]
2026-08-24 clock clk at 10 ns
    UART divisor and clk/pclk crossing limit to match.
2026-08-24 update journal with the 100 MHz target
    clk -4.11 ns, 1904 failing endpoints, all from the EX instruction register.
    [metrics.csv]
2026-08-27 add a register-read stage
    Forwarding from EX, bus request from WB registers, three-cycle multiply.
2026-08-27 update journal with the register-read stage
    clk -0.39 ns on 10 endpoints, mclk +2.18 ns, pclk +5.47 ns.
    [metrics.csv]
2026-08-27 update journal with Kogge-Stone carry
    clk -0.40 ns on 5 partial-product registers.
    [metrics.csv]
2026-08-29 update journal with Booth multipliers
    clk -1.02 ns on 34 endpoints. Gate-level simulation hangs on the unreset
    receive CRC.
    [metrics.csv]
2026-08-30 update journal with setup repair without buffering
    clk -1.85 ns on 37 endpoints.
    [metrics.csv]
2026-08-31 fix gate-level hangs: reset registers loaded with a constant
    [icache.v, rv32i.v]
2026-08-31 update journal with the multiplier operand registers
    clk -0.54 ns on 11 endpoints, all on the cache hit to fetch address path.
    Gate-level simulation passes.
    [metrics.csv]
2026-08-31 update journal with fetch ahead of the cache hit
    clk closes at 10 ns (+0.01 ns). Gate-level simulation hangs on an X from
    the unreset UART baud counter.
    [metrics.csv]
2026-08-31 fix gate-level hangs: reset the remaining control registers
    UART baud counters, interconnect response selects, port write flags, the CPU
    load flag.
    [axil_ic.v, rv32i.v, sdram.v, uart.v]
2026-08-31 update journal with the control resets
    clk +0.24 ns at 10 ns, mclk +1.99 ns, pclk +5.36 ns, hold, DRC and LVS clean.
    Both gate-level simulations pass.
    [metrics.csv]
2026-09-02 update journal with the PCIe removal
    clk +0.44 ns at 10 ns, mclk +1.95 ns, hold clean, DRC and LVS clean.
    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
    [metrics.csv]
2026-09-03 place the pad ring
    2.1 mm die: 82 pads, corners and bus slices.
2026-09-03 connect the pad supplies and strap them to the core ring
2026-09-03 time the I/O through the pads
    A timing copy of the gpiov2 liberty, 5 pF board load.
2026-09-05 count core power and KLayout errors outside the I/O cells
2026-09-05 update journal with the pad ring
    clk -2.87 ns on the SPI, UART and GPIO outputs, mclk -2.22 ns on SDRAM read
    data. LVS finds every supply shorted by the north and south pad straps.
    [metrics.csv]
2026-09-05 sample SPI MISO on the falling SCLK edge
2026-09-09 time the SPI pins against SCLK, leave UART and GPIO asynchronous
2026-09-09 fix supply shorts: route the pad straps on met3
2026-09-09 add the SkyWater seal ring
    2.12 mm die, pad ring 20 um in.
2026-09-09 update journal with the falling-edge captures, met3 straps and seal ring
    clk +0.86 ns, mclk +0.50 ns, hold clean, LVS clean, no DRC errors outside the
    SkyWater I/O cells. Gate-level simulation passes.
    [metrics.csv]
2026-09-11 source IR drop at the supply pad straps
2026-09-11 update journal with three-corner signoff
    ss fails setup by 8.32 ns on clk and 2.87 ns on mclk at 100 MHz, ff fails
    hold by 0.086 ns on 22 endpoints. IR drop 17.3 mV.
    [metrics.csv]
2026-09-12 update journal with the slow-corner clocks, hold margin and fill
    tt +0.96 / +0.42 ns, ss +1.98 / +1.47 ns, ff hold +0.019 ns, LVS and DRC
    clean, density check passes. Gate-level simulation passes.
    [metrics.csv]
2026-09-12 update journal with 10% slew and load margin
    Timing holds; two nets stay over the slow-corner slew limit.
    [metrics.csv]
2026-09-16 fix SRAM model read delay
    Data valid 0.53 ns after the falling edge.
    [sram_model.v]
2026-09-16 fix testbench reading the result before the pads settle
    [tb_soc.v]
2026-09-16 update journal with 50% slew margin and timed simulation
    All three corners close with no slew or load violation outside the waived
    SRAM pins. Timed simulation of the routed netlist passes.
    [metrics.csv]
2026-09-17 write spec v9 for a standalone die
2026-09-17 space the pad ring cells by measured clean distances
    12 um between gpiov2 pads and next to the lvc supply pads, 5 um next to the
    hvc pads, on a 2.35 mm die.
2026-09-17 update journal with spaced pads and electromigration
    No DRC error on the whole GDS with nothing waived. Two via4 crossings carry more
    than the tech LEF allows per cut.
    [metrics.csv]
2026-09-17 widen the met4 and met5 power stripes to 3.2 um
2026-09-17 update journal with wider stripes and the SkyWater I/O guide
    [metrics.csv]
2026-09-17 rebuild the pad ring after the SkyWater I/O guide
    gpiov2 pads abut with every other one mirrored, supply pads go in pairs, and the
    vssd/vccd pair keeps bus slices of at least 12 um outside. The die is 2.15 mm.
2026-09-17 update journal with the documented pad ring
    [metrics.csv]
2026-09-18 update journal with the 0.3 ns hold margin
    Hold closes at the fast corner. The timed simulation passes.
    [metrics.csv]
2026-09-18 check equivalence of the routed netlist
    Flops, SRAMs and pads are cut points matched by instance name; ABC proves the
    miter.
2026-09-18 check electromigration on the power grid
2026-09-18 update journal with the fab checks
    The routed netlist is proven equivalent, the power grid stays within its current
    limits, every layer is filled, and the GDS passes the PDK's checks with nothing
    waived.
    [metrics.csv, pads.csv]
